LeticiaVeran/smart-fall-detection-bracelet/photos/README.md

# 📸 Photos

Photos of the physical prototype and the alert screens.

## Final assembly (montagem final)

| Photo | What it shows |
|---|---|
| Internal wiring | Top-down view inside the case: ESP32, MPU6050 and jumpers |
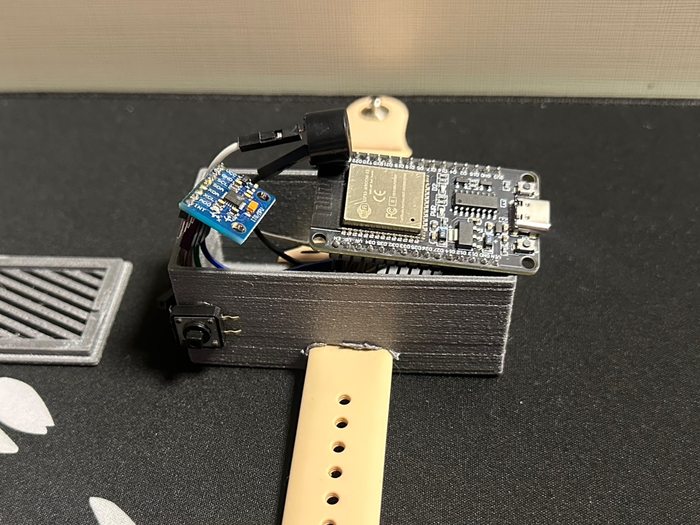
[picture p8: photos/assembled_components_closeup.jpg]
Components close-up
|  | Close-up of the MPU6050 (GY-521), the buzzer and the ESP32 |
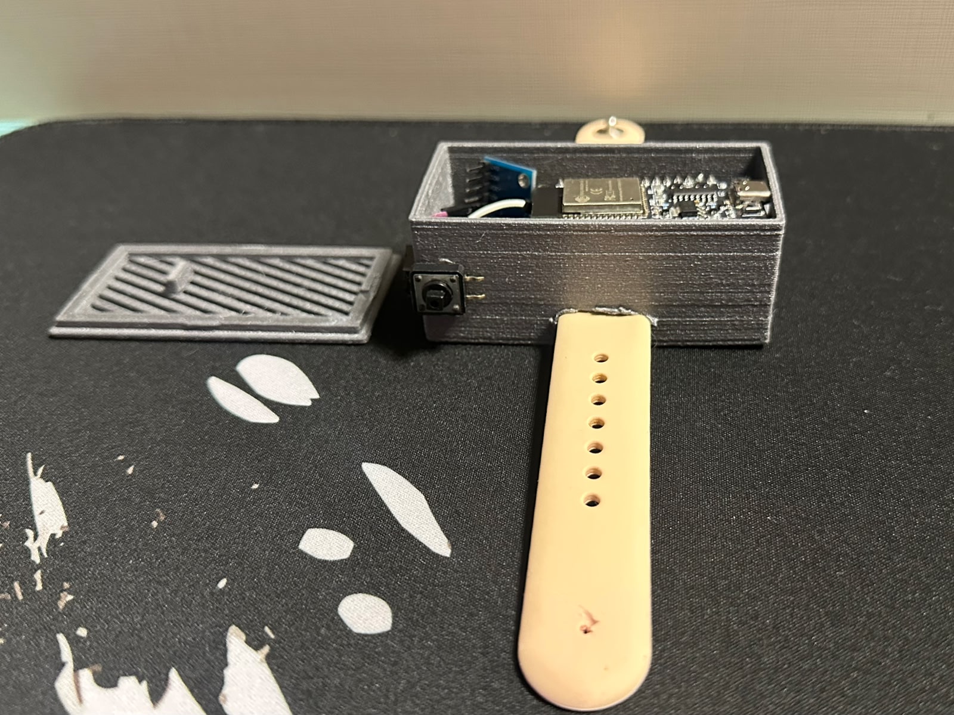
[picture p9: photos/assembled_open_with_lid.jpg]
Open with lid
|  | Open case next to its 3D-printed lid, with the emergency button on the side |
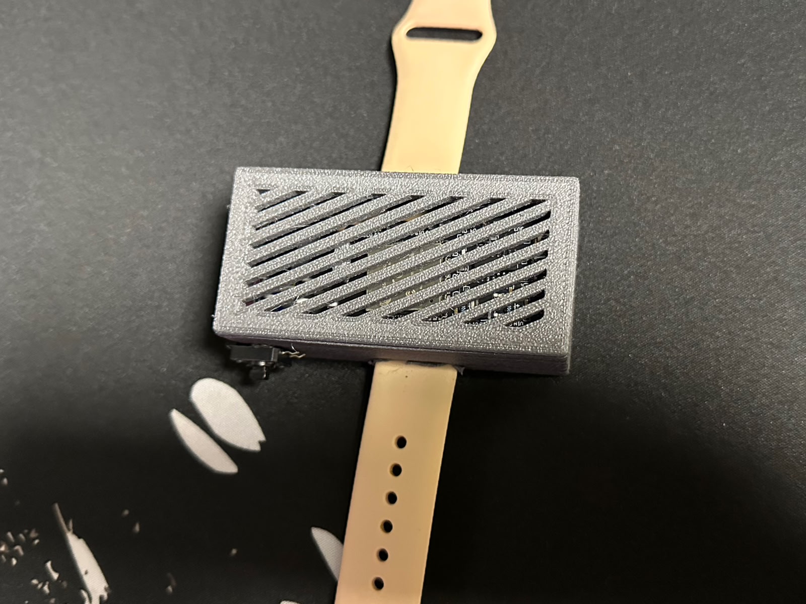
[picture p10: photos/enclosure_closed_top.jpg]
Closed top
|  | Closed case (vented lid) |
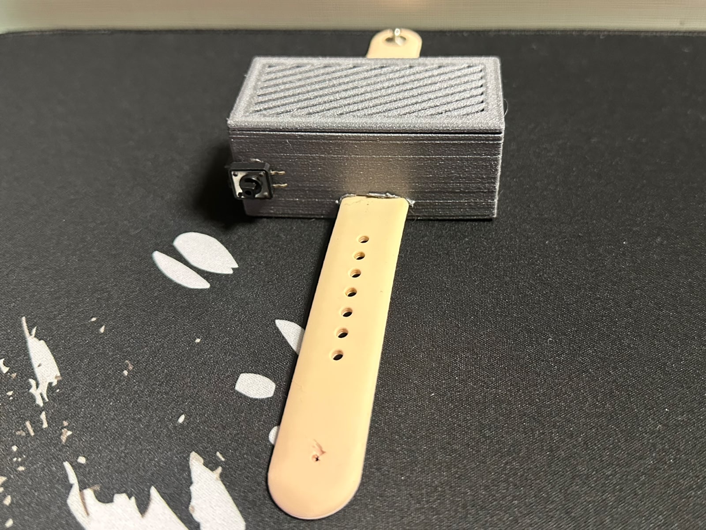
[picture p11: photos/enclosure_closed_with_strap.jpg]
Closed with strap
|  | Closed case with the wrist strap |
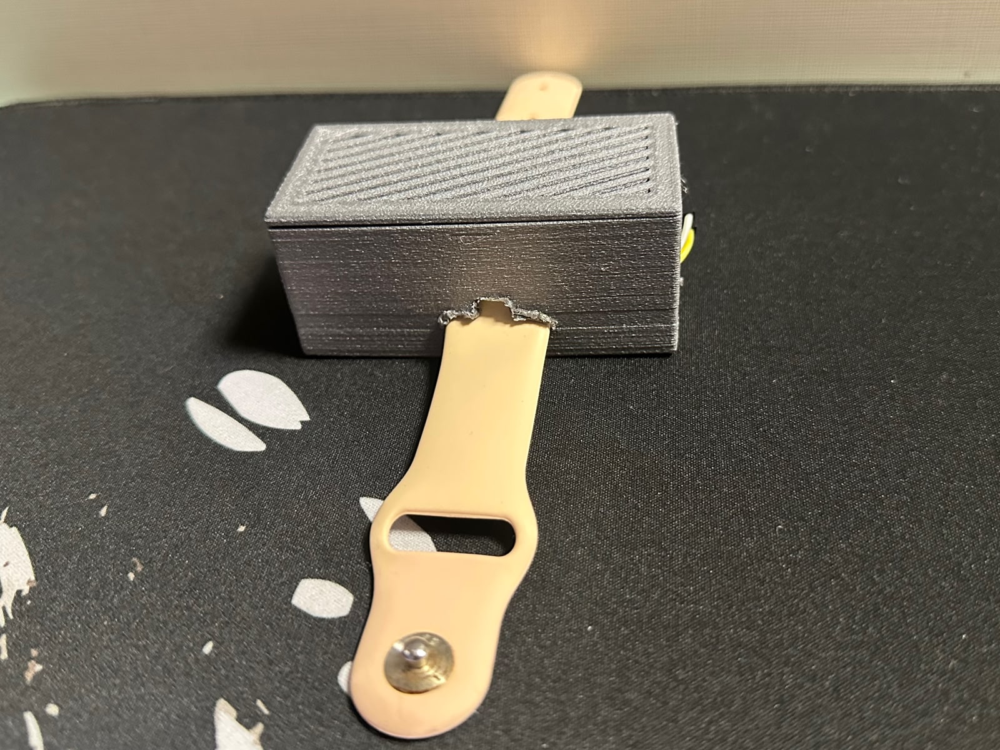
[picture p12: photos/enclosure_closed_side.jpg]
Closed side
|  | Side view of the closed case |
| On wrist | Bracelet worn on the wrist |
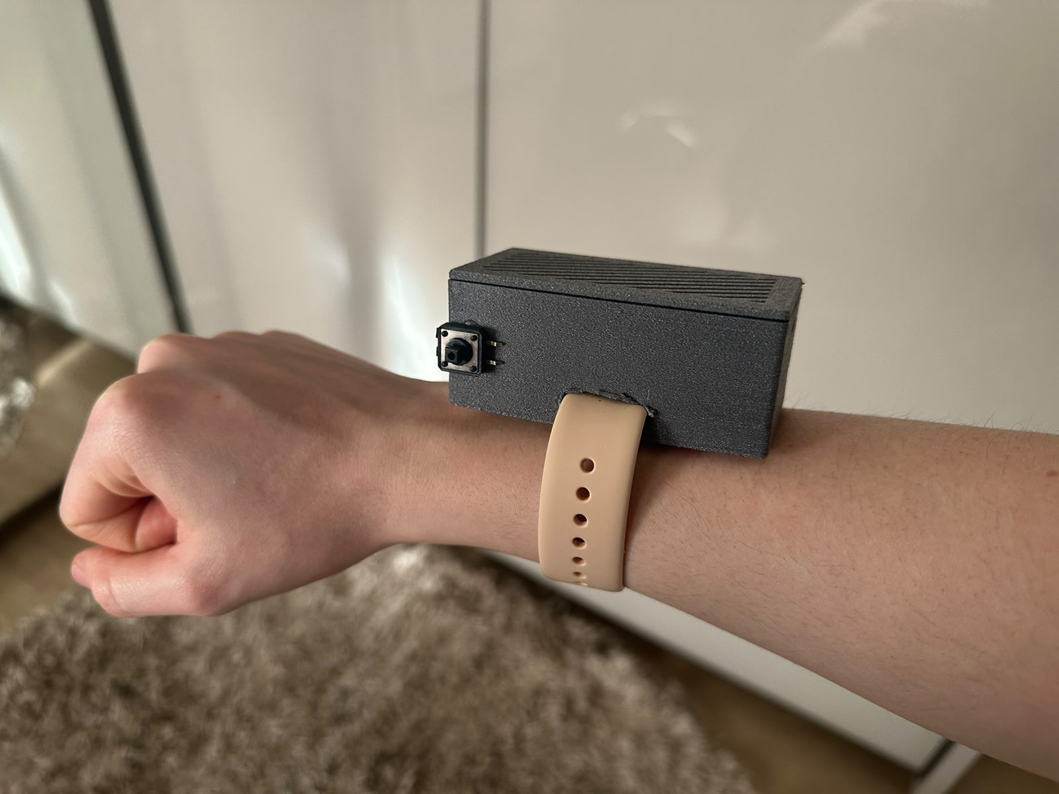
[picture p13: photos/bracelet_on_wrist_side.jpg]
On wrist side
|  | Worn on the wrist — the emergency button is reachable on the side |

> The enclosure is a deliberately simple 3D-printed prototype case. It came out
> bulky (it houses a full ESP32 DevKit on a breadboard-style wiring); a smaller
> case is listed as future work. Because it was only a quick prototype, no 3D
> model file (STL) is published.

## App screens (telas do sistema)

### Phone notifications

| Screen | What it shows |
|---|---|
| Fall detected | Persistent push notification on a fall (high confidence) |
| Manual emergency | Persistent push notification when the emergency button is pressed |

### Home Assistant (server side)

| Screen | What it shows |
|---|---|
| HA automations | The two active automations — `Bracelet — Fall Alert` and `Bracelet — Emergency Button` — with their last-triggered times |
| MQTT messages | The MQTT broker receiving live messages: `high_confidence` on `bracelet/fall` and `manual_button` on `bracelet/emergency` |
