LeticiaVeran/smart-fall-detection-bracelet/documentation/README.md

# 📚 Documentation

Technical documentation for the smart fall-detection bracelet.

## Full technical document (EN + PT)

The complete, illustrated technical document is available in both languages in
[`technical-document/`](technical-document/):

- 🇬🇧 [`Technical_Document_EN.docx`](technical-document/Technical_Document_EN.docx)
- 🇧🇷 [`Documentacao_Tecnica_PT.docx`](technical-document/Documentacao_Tecnica_PT.docx)

Both contain the same content (introduction, system overview with the
connection diagram, hardware, firmware/algorithm, server, results with photos,
and conclusion).

## Other documents

| Item | What it contains |
|---|---|
| [`literature/theoretical-background.md`](literature/theoretical-background.md) | The science behind the code — fall-detection theory, the 3-phase model, sensor physics, parameter justification, references |
| [`literature/references/`](literature/references/) | The two source papers (Bourke & Lyons 2008; Al-Dahan et al. 2016) in PDF |
| [`requirements/requirements.md`](requirements/requirements.md) | Functional and non-functional requirements (from the official project brief) |
| [`design_docs/architecture.md`](design_docs/architecture.md) | System architecture and design decisions |
| [`user_manual/user_manual.md`](user_manual/user_manual.md) | How to operate the bracelet day to day |
