LeticiaVeran/smart-fall-detection-bracelet/design/schematics/wiring_diagram.png

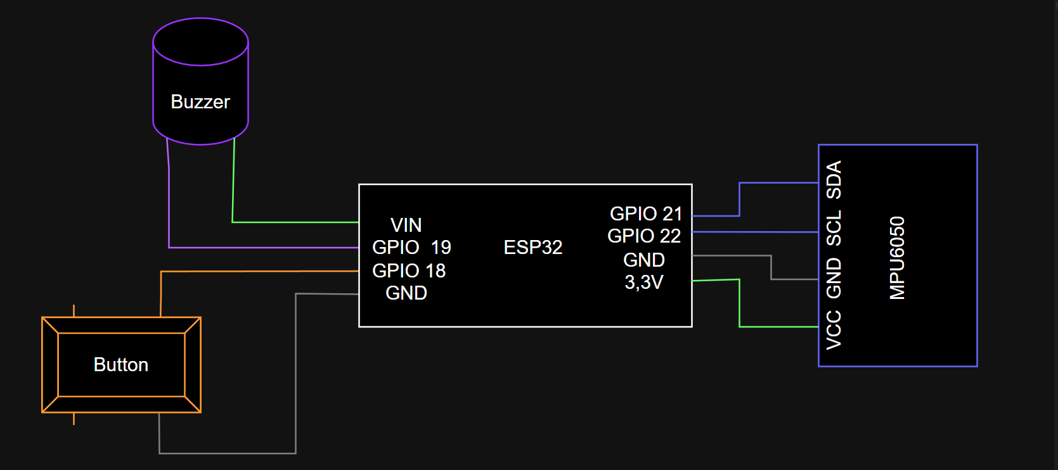
design/schematics/wiring_diagram.png
